frnmst/esp8266-iot-gas-detector/kicad/gas_sensor.kicad_sch

## KiCad design kicad/gas_sensor.kicad_sch (2026-06-18)

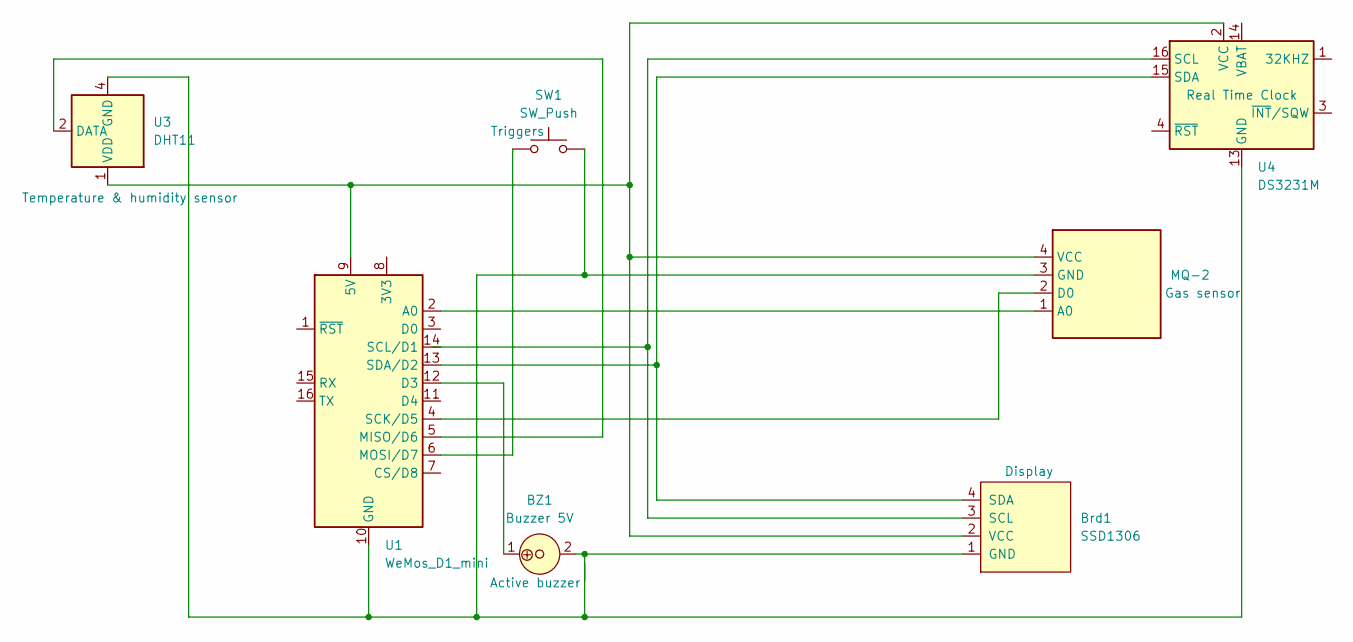
[picture p3: schematic gas_sensor.kicad_sch]

Parts:
BZ1: Buzzer 5V; MagneticBuzzer_ProSignal_ABT-410-RC
Brd1: SSD1306
SW1: SW_Push
U1: WeMos_D1_mini; WEMOS_D1_mini_light
U2: MQ-2; MQ-6
U3: DHT11; Aosong_DHT11_5.5x12.0_P2.54mm
U4: DS3231M; SOIC-16W_7.5x10.3mm_P1.27mm

Connections:
unnamed: BZ1.1, U1.12 (D3)
unnamed: BZ1.2, Brd1.1 (GND), SW1.2, U1.10 (GND), U2.3 (GND), U3.4 (GND), U4.5 (GND), U4.6 (GND), U4.7 (GND), U4.8 (GND), U4.9 (GND), U4.10 (GND), U4.11 (GND), U4.12 (GND), U4.13 (GND)
unnamed: Brd1.2 (VCC), U1.9 (5V), U2.4 (VCC), U3.1 (VDD), U4.2 (VCC)
unnamed: Brd1.3 (SCL), U4.16 (SCL)
unnamed: Brd1.4 (SDA), U1.13 (SDA/D2), U4.15 (SDA)
unnamed: SW1.1, U1.6 (MOSI/D7)
unnamed: U1.2 (A0), U2.1 (A0)
unnamed: U1.4 (SCK/D5), U2.2 (D0)
unnamed: U1.5 (MISO/D6), U3.2 (DATA)
