frnmst/esp8266-iot-gas-detector/project_alpha/config.h

/* version 0.16.0
 *
 * MIT License
 *
 * Copyright (c) 2024-2026 Franco Masotti
 *
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
 * THE SOFTWARE IS PROVIDED "AS IS", WITHOUT WARRANTY OF ANY KIND, EXPRESS OR
 * IMPLIED, INCLUDING BUT NOT LIMITED TO THE WARRANTIES OF MERCHANTABILITY,
 * FITNESS FOR A PARTICULAR PURPOSE AND NONINFRINGEMENT. IN NO EVENT SHALL THE
 * AUTHORS OR COPYRIGHT HOLDERS BE LIABLE FOR ANY CLAIM, DAMAGES OR OTHER
 * LIABILITY, WHETHER IN AN ACTION OF CONTRACT, TORT OR OTHERWISE, ARISING FROM,
 * OUT OF OR IN CONNECTION WITH THE SOFTWARE OR THE USE OR OTHER DEALINGS IN THE
 * SOFTWARE.
 */
#ifndef CONFIG_H
#define CONFIG_H

#include "common.h"
#include "version.h"

/* Button action triggers. */
typedef bool (*ActionFunc)();

/* Triggers must be sorted by dsc thresholdMs. */
const int triggerThresholdMs = 500;
struct ButtonTrigger {
    ActionFunc action;
    bool needsWiFi;
    const char* name;
    const char* displayName;
};

/* Function prototype for triggers. */
bool togglePomodoroTimer();
bool toggleShowCurrentTimeOnly();
bool toggleDisplay();
bool selfTest();
bool toggleConfigPortal();
bool togglePrintDebug();
bool doOTA();
bool noop();
bool credits();

struct Config {
    struct Debug {
        static bool PRINT;
    };
    struct HardwareFeatures {
        static bool DS3231;
        static bool SSD1306;
        static bool DHT11;
        static bool MQ_2;
        static bool MQ_135;
    };
    struct Network {
        static bool SEND_TO_API;
        static const char* HOST;
        static const int PORT;
        static const bool USE_SSL;
        static const char* ENDPOINT;
        static const char* BOARD_ID;
        static const char* AUTHORIZATION_BEARER_TOKEN;
        static const char* WEBHOOK_ID;
        static const char* USER_AGENT;
        static const int SEND_DATA_FREQUENCY_MS;
        static const bool FULL_DEBUG;
        static const bool BASIC_DEBUG;
    };

    struct OTA {
        struct Auth {
            static const char *PASSWORD_MD5_HASH;
        };
        struct Generic {
            static const char *HOSTNAME;
        };
    };

    struct Wifi {
        static const bool WORK_ONLINE;
        static const bool IGNORE_MISSING_WIFI_ON_MANUAL = true;

        // true to setup WiFi manually without the wizard.
        static bool MANUAL;
        static unsigned int WIFIMANAGER_CONFIG_PORTAL_TIMEOUT_SECONDS;

        /* In auto mode, these are the config access point credentials.
         * In manual mode these are the actual values of the AP.
         */
        static const char* SSID;
        static const char* PASSWORD;

        struct Manual {
            static const IPAddress LOCAL_IP;
            static const IPAddress GATEWAY;
            static const IPAddress SUBNET;
            static const IPAddress DNS;
        };

        struct Auto {
            /* Set to true if you need to wipe saved WiFi credentials from the ROM (WiFiManager),
             * then push the sketch, then set it back to false before pushing it again.
             * Config::Wifi::WORK_ONLINE must be set to `true`.
             */
            static bool RESET_WIFI_SETTINGS;
        };
    };

    struct Display {
        static int ROTATION;
        static const int WIDTH = 128;
        static const int HEIGHT = 64;
        static const bool PERIODIC_COLOR_INVERT = false;
        static const unsigned int DISPLAY_TIMEOUT_MS = 500;
        static const unsigned int DISPLAY_DEBUG_DATA_FREQUENCY_MS;
    };

    struct Rtc {
        static const int unsigned RTC_GET_UPDATE_FREQUENCY_MS = 500;
        static const int unsigned RTC_SET_UPDATE_FREQUENCY_MS = 3600;
    };

    struct Sensor {
        struct Setting {
            static const unsigned int READING_TIMEOUT_MS;

            // Timeout during the initial boot phase.
            static const unsigned int BOOT_READING_TIMEOUT_MS;

            // Total number of readings in memory (circular array).
            static constexpr int READINGS_BUFFER = 8;

            static const int DHT_TYPE = DHT11;
            static const int MQ_2_WARM_UP_MS;
        };

        struct MeasurmentOffset {
            static float TEMPERATURE_CELSIUS_DHT11;
            static float TEMPERATURE_CELSIUS_DS3231;
            static float HUMIDITY_PERCENT;
            static float GAS_VOLTS;
        };

        struct Alarm {
            static const int BUZZER_SENSOR_ERROR_ITERATIONS = 10;
            static const int BUZZER_SENSOR_ERROR_DELAY_MS = 500;
        };
    };

    /* Board specific data. */
    #if defined(ESP8266)
        #include "boards/esp8266.h"
    #elif defined(ESP32)
        #include "boards/esp32.h"
    #else
        #error "unsupported arch!"
    #endif

    struct Triggers {
        static const float GAS_ALARM_VOLTS_THRESHOLD;
        static const int GAS_ALARM_TENDENCY_ITERATIONS;

        // If set to true, do not raise an alarm if the gas tendency passes GAS_ALARM_TENDENCY_ITERATIONS.
        static const bool IGNORE_GAS_TENDENCY = true;
        static const bool IGNORE_GAS_VOLTAGE = true;
    };

    struct DateTime {
        static const char* NTP_SERVERS[];
        static const long COMPILATION_SECONDS_OFFSET;
        struct Tz {
            static char POSIX[50];
            static const long COMPUTER_NAIVE_TIME_TO_UTC_SECONDS_OFFSET;
        };
        struct Format {
            static char TIME[32];
            static char DATE[32];
        };
    };

    struct WarmingUpInfo {
        /* These strings are displayed randomly during the MQ-5 warmup phase.
         * Easer egg!
         */
        static const char* TEXT[];
        static const int TEXT_LENGTH;
    };

    struct Init{
        static const int HARDWARE_OUTPUT_DELAY_MS = 50;
    };

    struct Other {
        static const char* GAS_ALARM_TEXT;

        // Display extra debug only if main debug is enabled.
        static const bool DISPLAY_EXTRA_DEBUG_INFO = true;

        static const int DEBUG_SPEED = 115200;

        static const int BUILTIN_LED_MAX_PWM_VALUE = 255;
        static const bool ENABLE_LED_HEARTBEAT;
        static const int BUILTIN_LED_HEARTBEAT_INTERVAL = 50;
    };
};

#include "arduino_secrets.h"

#endif // CONFIG_H
