frnmst/esp8266-iot-gas-detector/project_alpha/boards/esp8266.h

#ifndef BOARDS_ESP8266_H
#define BOARDS_ESP8266_H

/* Use GPIO pin ids.
 * GPIO ids are on the positive (+) side.
 */
struct Pins {
    struct Digital {
        static const int BUZZER = 0;            // GPIO  0: D3
        static const int DHT_11 = 12;           // GPIO 12: D6
        static const int MQ_2 = 14;             // GPIO 14: D5
        static const int BUTTON_A = 13;         // GPIO 13: D7
        static const int LED = LED_BUILTIN;     // GPIO 2:  D4
    };
    struct Analog {
        static const int RTC = 999;
        static const int MQ_2 = A0;
    };
};

#endif
