frnmst/esp8266-iot-gas-detector/(commit log)

2025-06-28 Improve config
    - Simplify and improve configuration
    - Add time offset after sketch is uploaded
    - Fix calibration values
    - Fix sketch name and dir to be used with Arduino IDE without changes
    [config.h, config.ino, project_alpha.ino, version.h]
2025-11-08 Fix STD DST change
    - Date and time is now correctly stored and updated on the board
    besides just the RTC: now DST and STD changes should be automatic.
    [config.h, config.ino, project_alpha.ino]
2025-11-28 Add features
    - Add more debug on-display prints.
    - Add temperature and humidity tendencies as arrow symbols.
2025-11-28 Add debug print
    - Add software version debug print.
    - Bump version.
2026-01-04 Decrease boot time
    - Avoid unecessary MQ-2 heating phase if sensor is ready.
    - Use built-in led for notification and heartbeat.
    [config.h, config.ino, project_alpha.ino, version.h]
2026-01-04 Fixes
    - Improve boot speed.
    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
    [config.h, config.ino, project_alpha.ino, version.h]
2026-01-06 Add modularity
    - Hardware setup is now toggable.
    - Fix variables.
    - Add self-test as GPIO pin input.
    [config.h, config.ino, project_alpha.ino]
2026-01-07 Documentation
    - Add power usage and special pins in docs.
    - Bump version id.
2026-01-10 Improve self test
    - Self test sensors.
    - Improve loop.
    - Drop useless variable.
2026-01-10 Bump
    - Fix readme.
    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
    [config.h, config.ino, project_alpha.ino, version.h]
2026-02-12 Update electric schema
    [gas_sensor.kicad_sch]
2026-02-28 Multi-board support
    - Test the sketch on an ESP32.
    - Add specific board definitions.
    - Fix a couple of bugs.
    [config.h, config.ino, esp32.h, esp8266.h, project_alpha.ino, version.h]
2026-03-09 Home Assistant ready
    - Prepare software to be Home Assistant ready.
    - Create separate secret configuration.
    - Minor bug fixes and cleanup.
    [arduino_secrets.example.h, config.h, config.ino, project_alpha.ino]
2026-03-13 Add OTA
    - Add support for updates via OTA.
    - Add support for multiple generic triggers on the same button.
    - Improve stability and speed.
    [arduino_secrets.example.h, config.h, config.ino, project_alpha.ino, version.h]
2026-03-15 Drop Strings
    - Drop C++ string object in place of traditional char C arrays.
    This should improve memory stability.
    [arduino_secrets.example.h, project_alpha.ino]
2026-03-18 Fix strings
    - Replace all String objects into char[] or char*.
    - Improve sketch checksum checking.
    - Change some variable names and move others into the secret
    configuration file.
    - Code cleanup and bug fixes.
    - Improve easter egg function.
    [arduino_secrets.example.h, config.h, config.ino, esp32.h, esp8266.h]
2026-03-18 Commit fixes
    - See previous commit comments.
    [project_alpha.ino]
2026-04-01 Fix time management
    - Use native ESP libraries to manage NTP.
    [arduino_secrets.example.h, config.h, project_alpha.ino]
2026-04-03 Fix network
    - Improve network stability and offline visual notification.
    [arduino_secrets.example.h, project_alpha.ino]
2026-04-08 Cleanup
    - Fix bug and library reference.
    [arduino_secrets.example.h]
2026-04-09 Fix README
    - Fix flowchart
2026-04-10 Add trigger
    - Add new pin trigger: `toggleShowCurrentTimeOnly()`
2026-04-10 Add trigger
    - Add show time only pin trigger.
2026-06-18 Split code into modules
    - Add pin triggers.
    - Improve logic and delays.
    - Improve trigger mode output.
    - Loop through triggers.
    - Don't wait for MQ-* to heat up in setup, use loop.
    - Initial support for function-based unit tests.
    - Add basic pomodoro timer support.
    - Fix pin definitions.
    - Cleanup and fix documentation.
    [gas_sensor.kicad_sch]
